Elipsit/ext-led-jewlery/.pics/FLIR0085.jpg

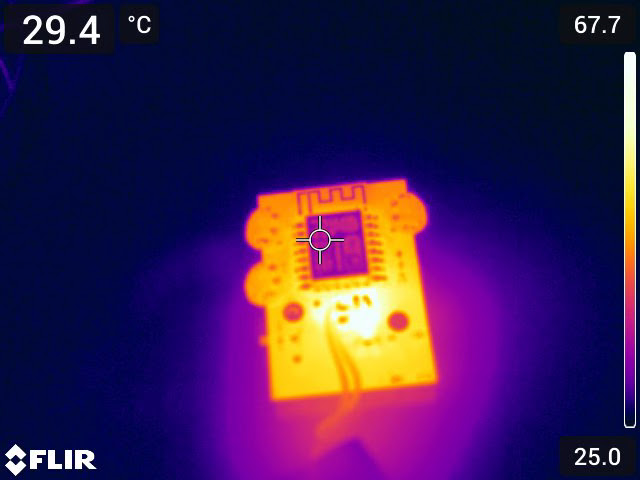
.pics/FLIR0085.jpg
