Elipsit/ext-led-jewlery/.pics/IMG_2793.PNG

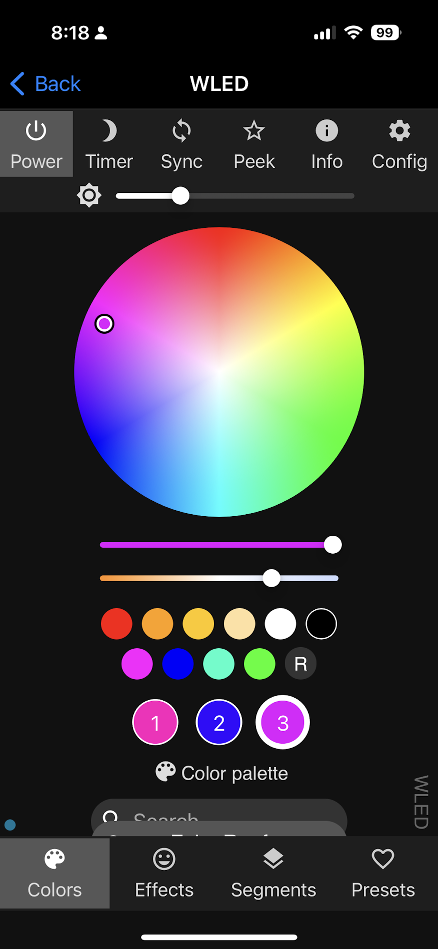
.pics/IMG_2793.PNG
