Elipsit/ext-led-jewlery/.pics/IMG_3061.jpg

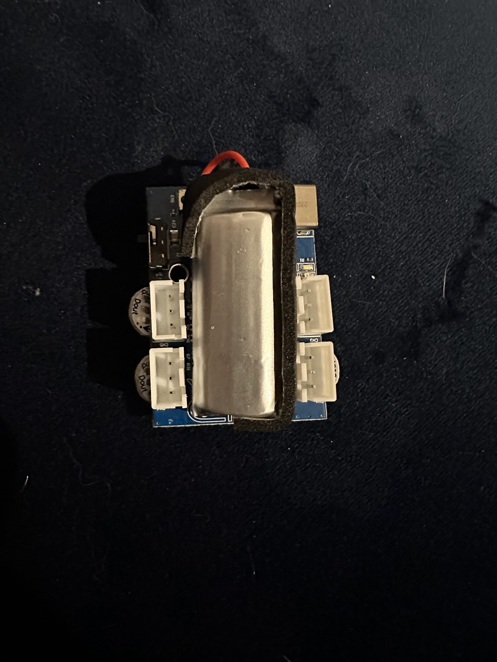
.pics/IMG_3061.jpg
