Elipsit/ext-led-jewlery/.pics/IMG_3925.jpg

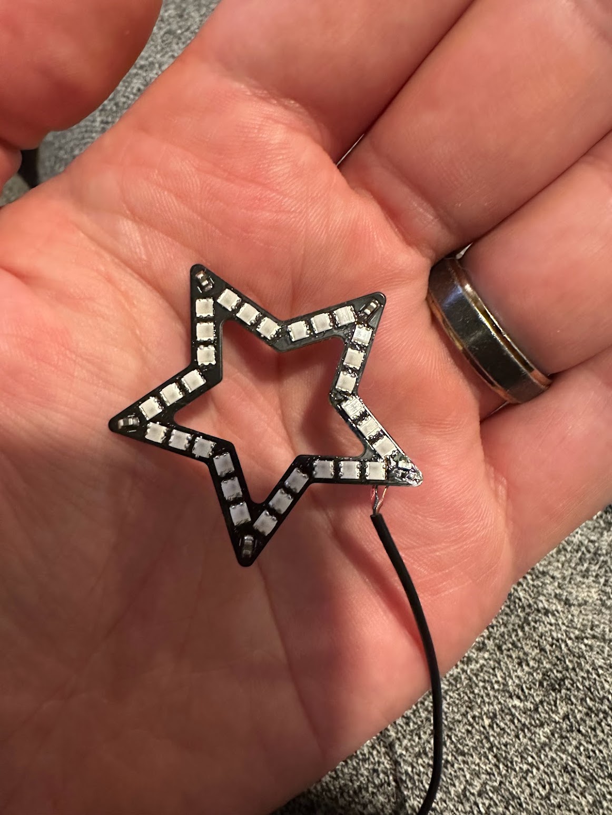
.pics/IMG_3925.jpg
