Elipsit/ext-led-jewlery/.pics/IMG_4481.jpg

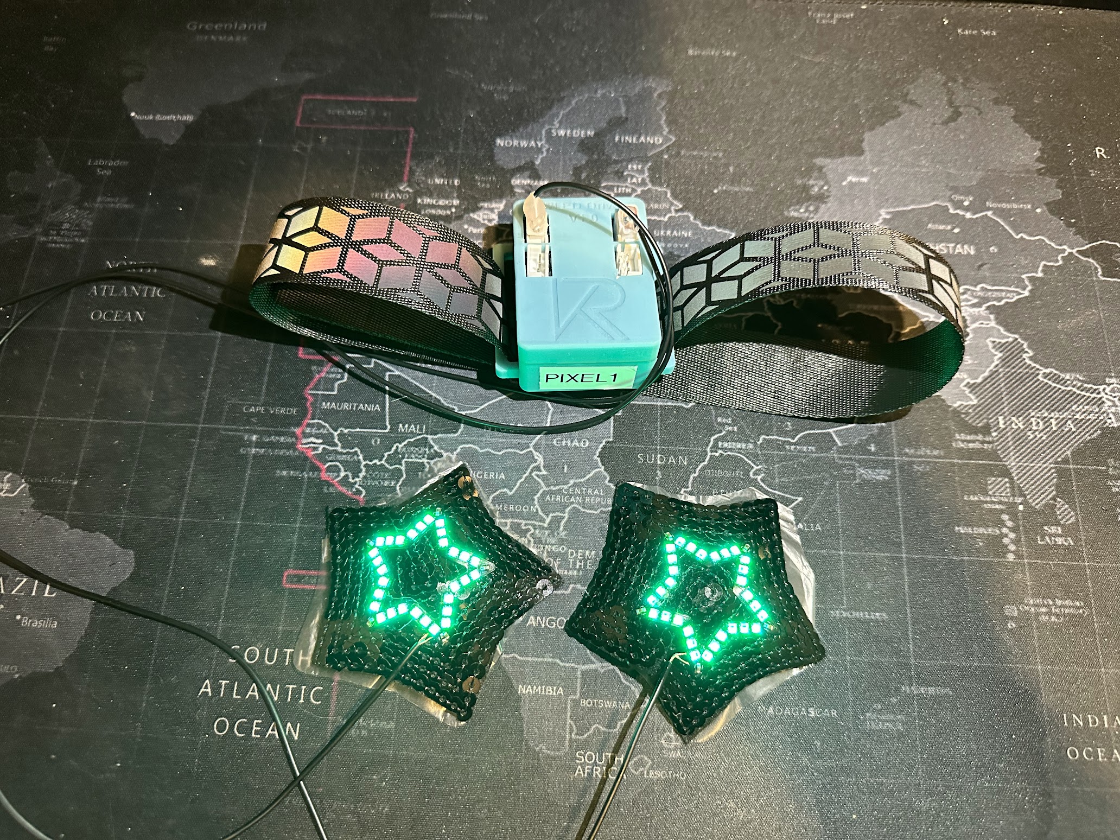
.pics/IMG_4481.jpg
