Elipsit/ext-led-jewlery/.pics/Proto.png

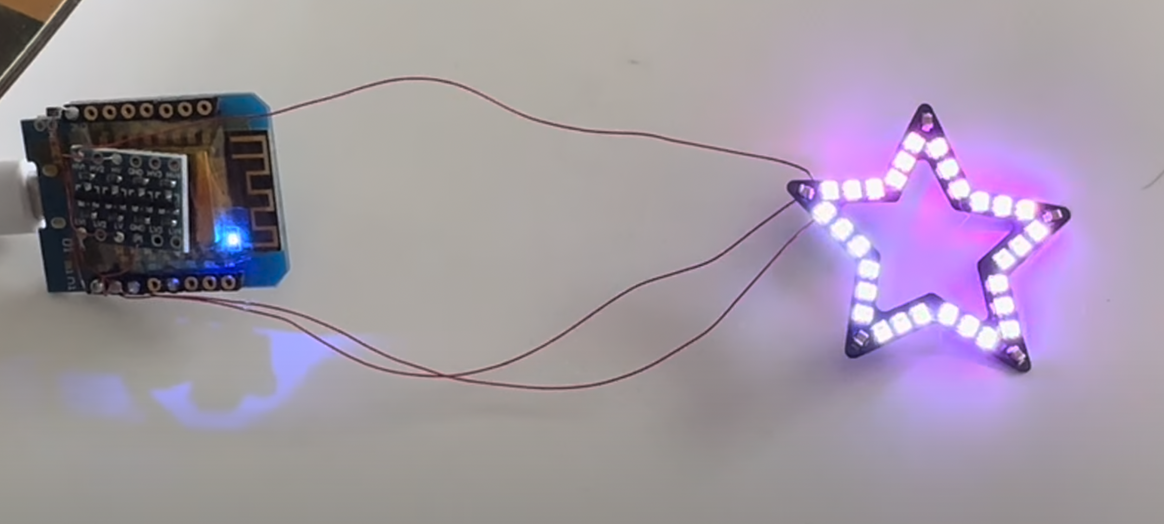
.pics/Proto.png
