Elipsit/ext-led-jewlery/EE/Project Outputs for LED_Star_RGB_Rev_A/Folder Structure/ExportSTEP/LED_Star_RGB_Rev_A.step

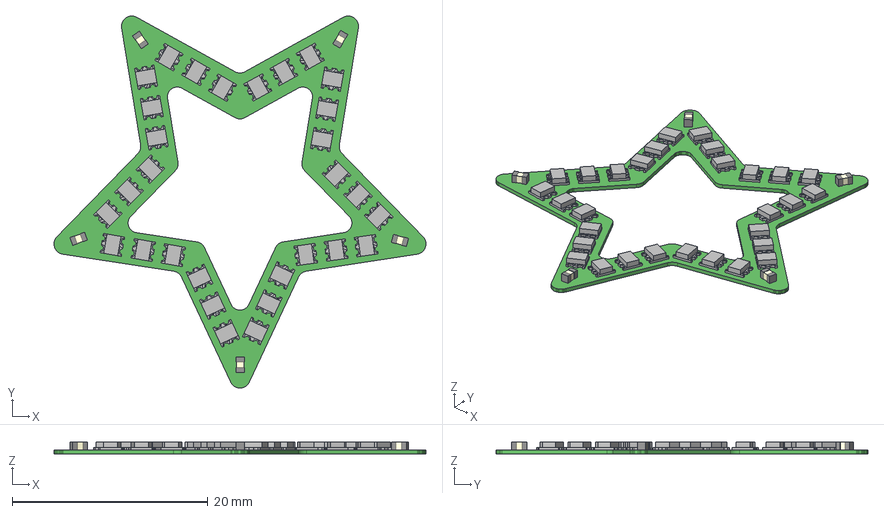
[picture p13: CAD file, 2023-07-20]
EE/Project Outputs for LED_Star_RGB_Rev_A/Folder Structure/ExportSTEP/LED_Star_RGB_Rev_A.step
38.0 x 38.0 x 1.27 mm
User Library-WS2812-2020_RGB8421504 x 30
Capacitor 0603 x 5
