Elipsit/ext-led-jewlery/ME/bot-esp-neopixel-driver-Case-tabs v42.stl

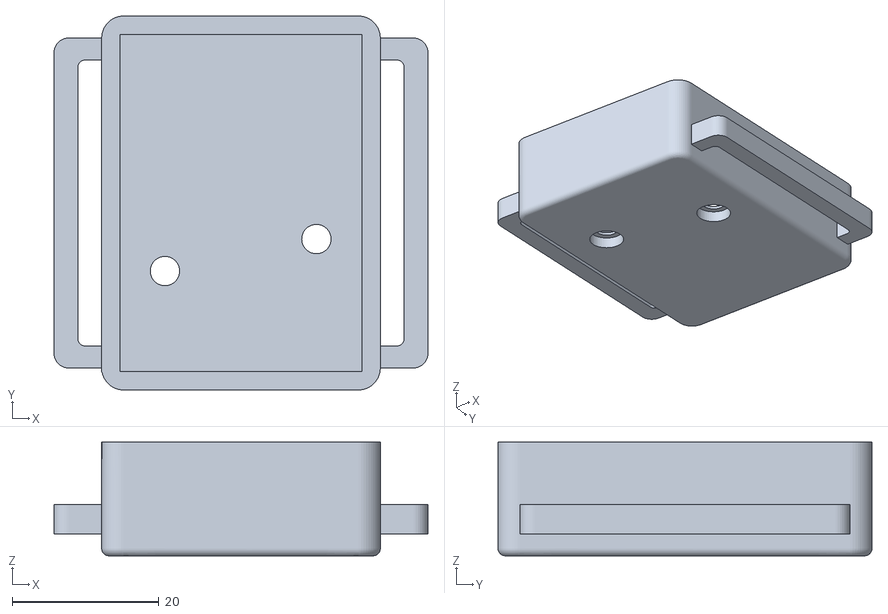
[picture p14: CAD file, 2023-07-24]
ME/bot-esp-neopixel-driver-Case-tabs v42.stl
51.0 x 51.0 x 15.5
