Elipsit/ext-led-jewlery/ME/top-esp-neopixel-driver-Case-tabs v43.stl

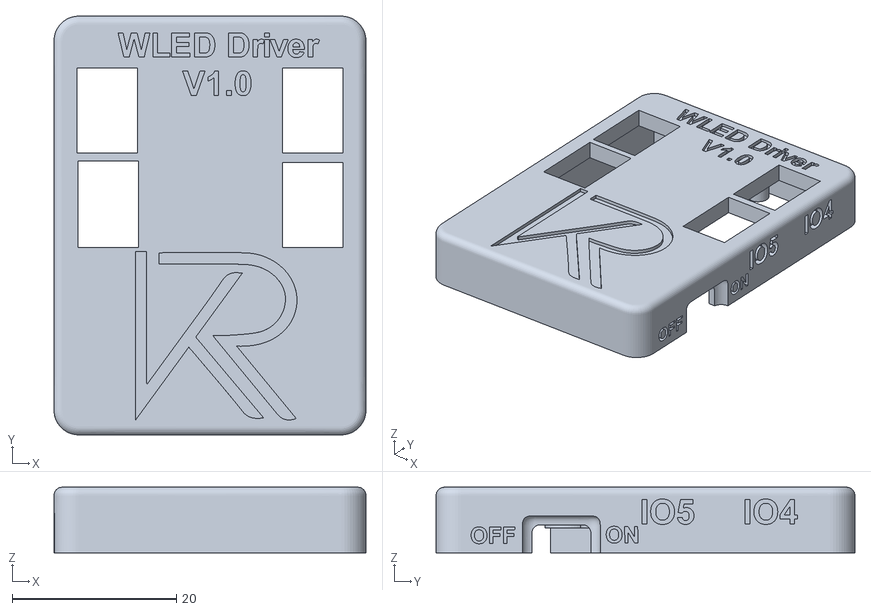
[picture p15: CAD file, 2023-07-24]
ME/top-esp-neopixel-driver-Case-tabs v43.stl
38.0 x 51.0 x 8.00
