Elipsit/ext-led-jewlery/EE/Project Outputs for esp-neopixel-driver/Schematic/esp-neopixel-driver-2023-07-03.PDF

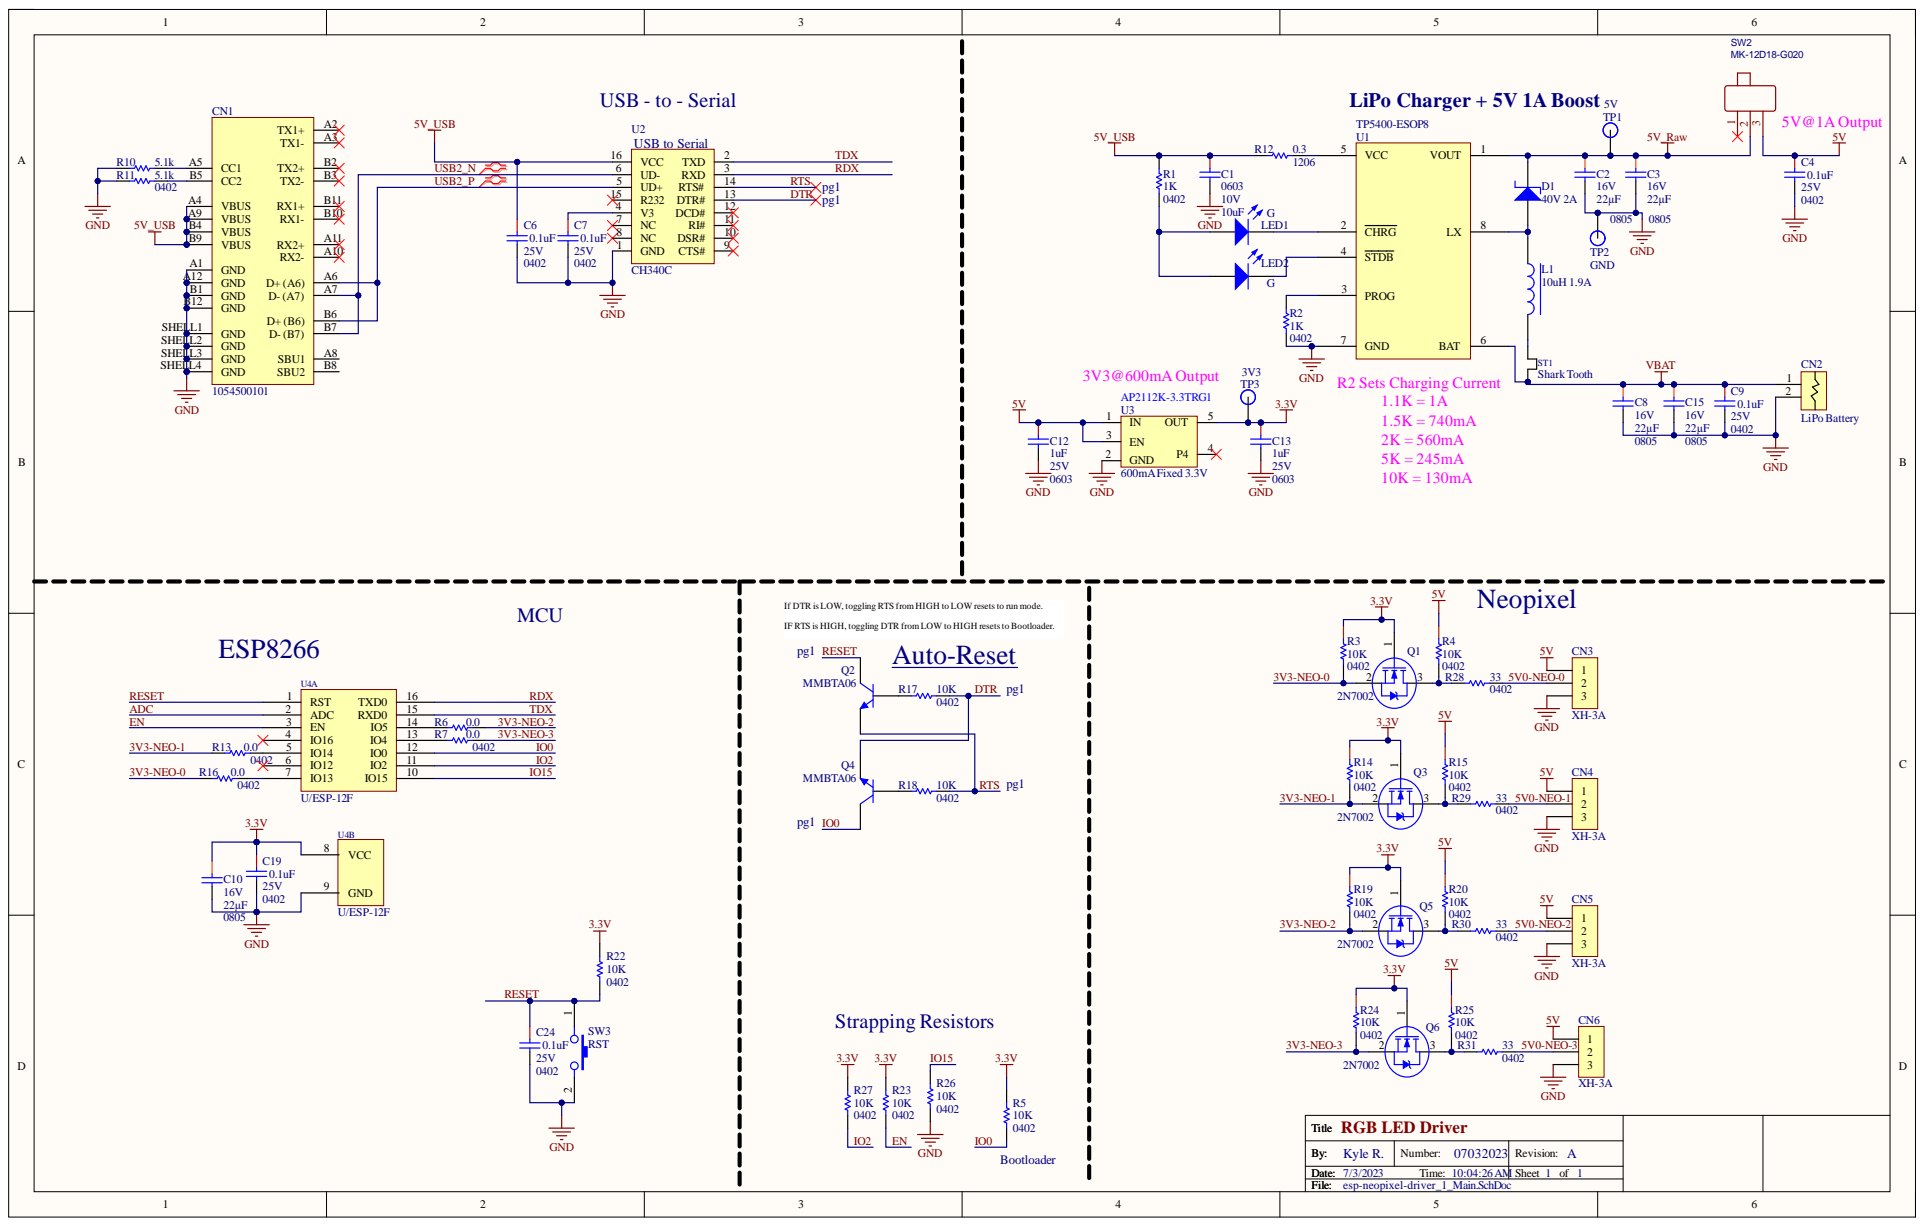
[picture p16: page 1]

If DTR is LOW, toggling RTS from HIGH to LOW resets to run mode.

IF RTS is HIGH, toggling DTR from LOW to HIGH resets to Bootloader.

RGB LED Driver Title Title

By: By: Kyle R. | Number: 07032023 | Revision: A
Date: Date: 7/3/2023 Time: 10:04:26 AM | | Sheet 1 of 1

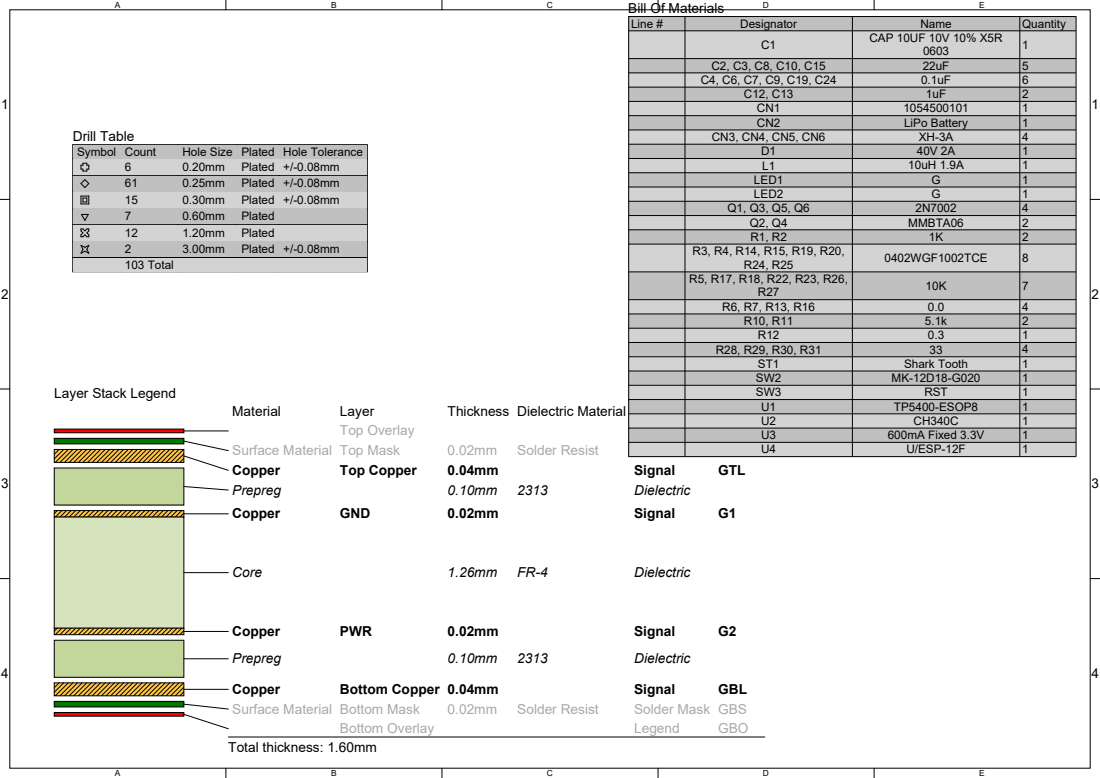
[picture p17: page 2]

Line # | Designator | Name | Quantity

C1 | CAP 10UF 10V 10% X5R 0603 | 1

C2, C3, C8, C10, C15 | 22uF | 5
C4, C6, C7, C9, C19, C24 | 0.1uF | 6

C12, C13 | 1uF | 2
CN1 | 1054500101 | 1
CN2 | LiPo Battery | 1

15 | 0.30mm | Plated | +/-0.08mm
7 | 0.60mm | Plated
12 | 1.20mm | Plated

LED2 | G | 1
Q1, Q3, Q5, Q6 | 2N7002 | 4
Q2, Q4 | MMBTA06 | 2
R1, R2 | 1K | 2

103 Total

R6, R7, R13, R16 | 0.0 | 4
R10, R11 | 5.1k | 2
R12 | 0.3 | 1

ST1 | Shark Tooth | 1
SW2 | MK-12D18-G020 | 1
SW3 | RST | 1
U1 | TP5400-ESOP8 | 1
U2 | CH340C | 1
U3 | 600mA Fixed 3.3V | 1
U4 | U/ESP-12F | 1

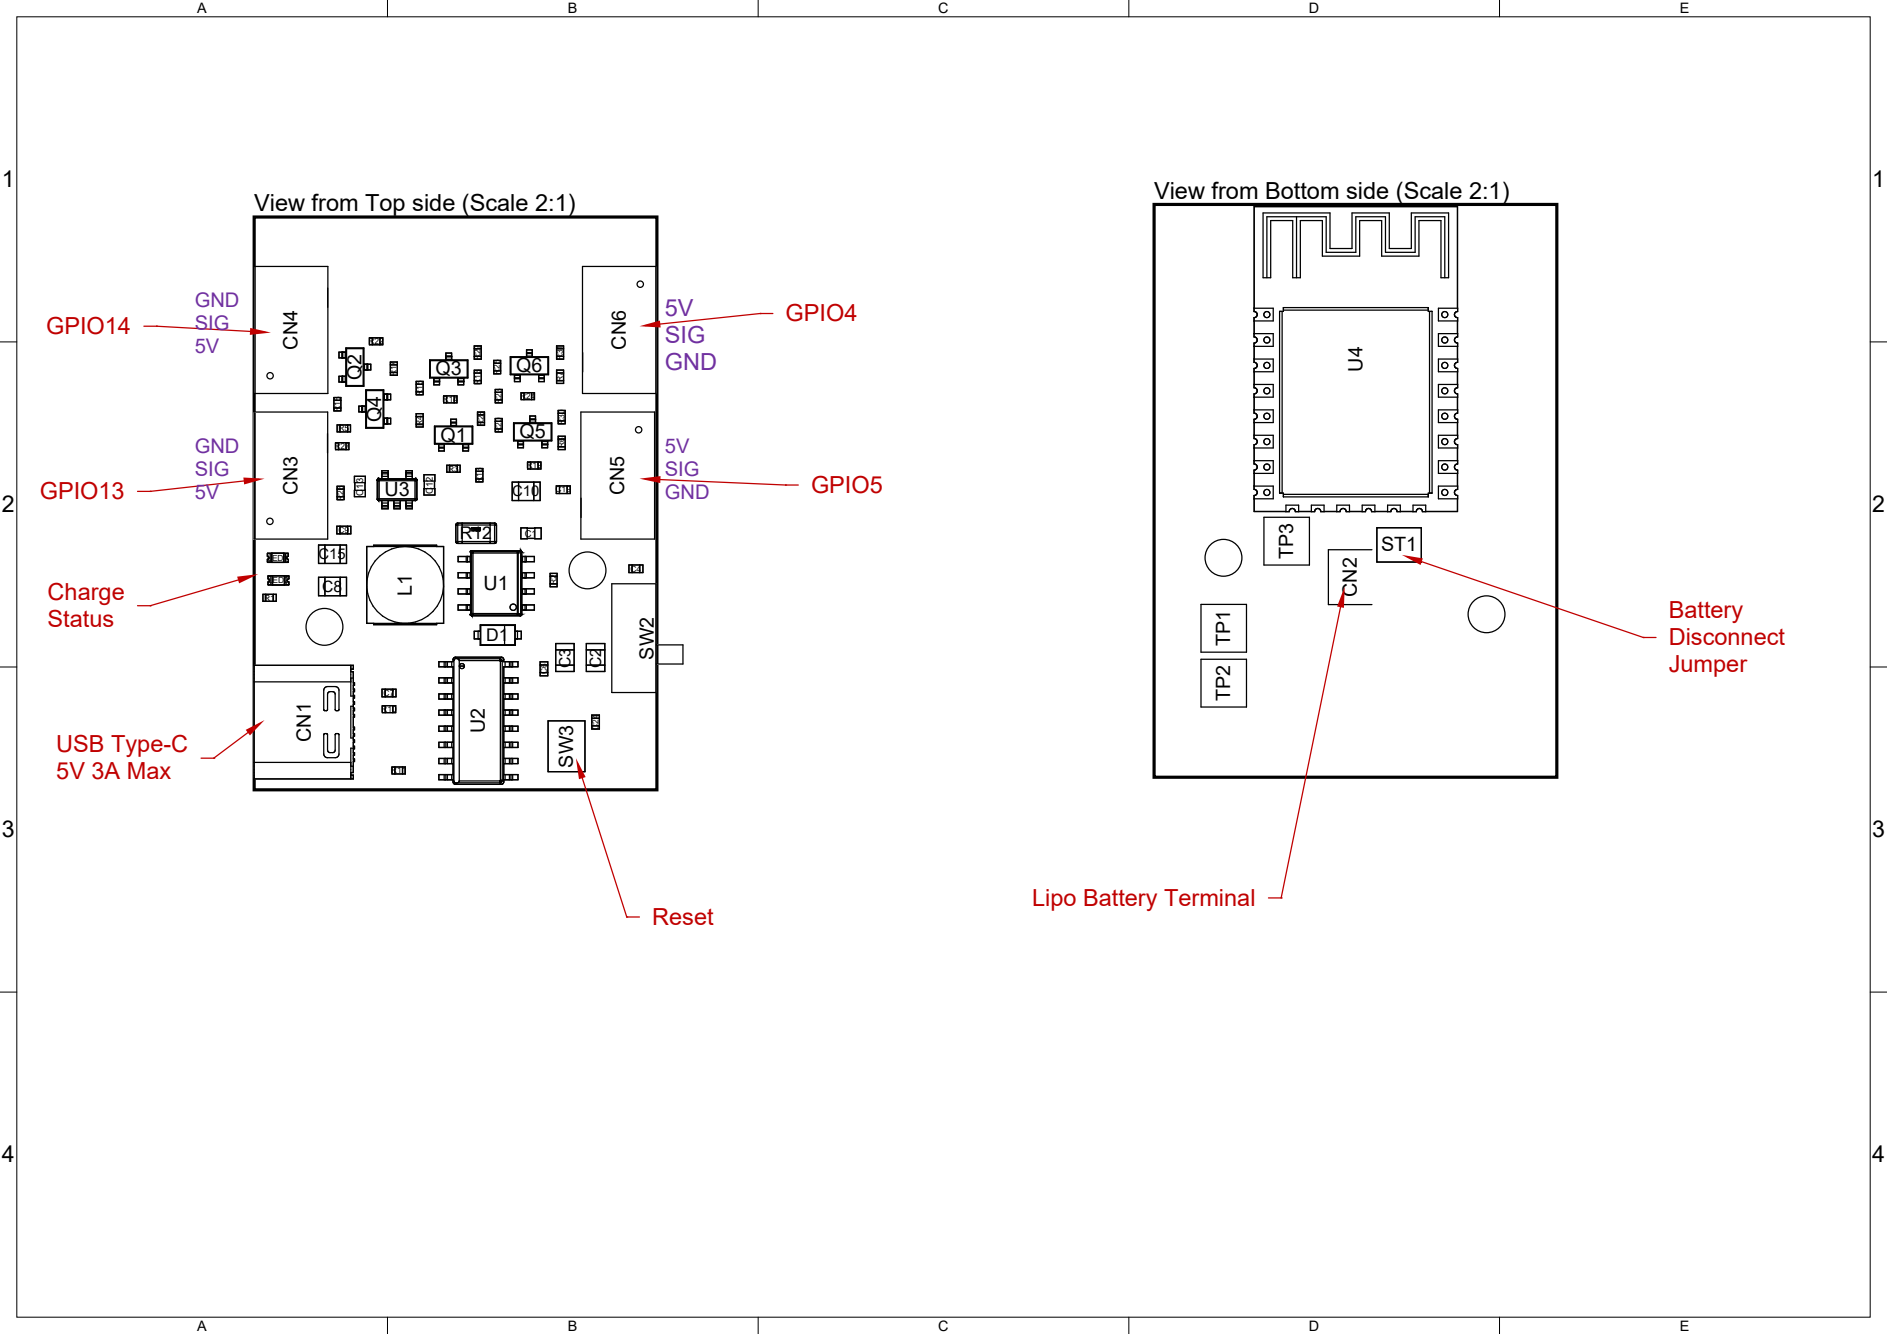
[picture p18: page 3]

View from Bottom side (Scale 2:1)

View from Top side (Scale 2:1)
