Elipsit/ext-led-jewlery/EE/Project Outputs for LED_Star_RGB_Rev_A/Schematic/LED_Star_RGB_Rev_A-2023-01-22.PDF

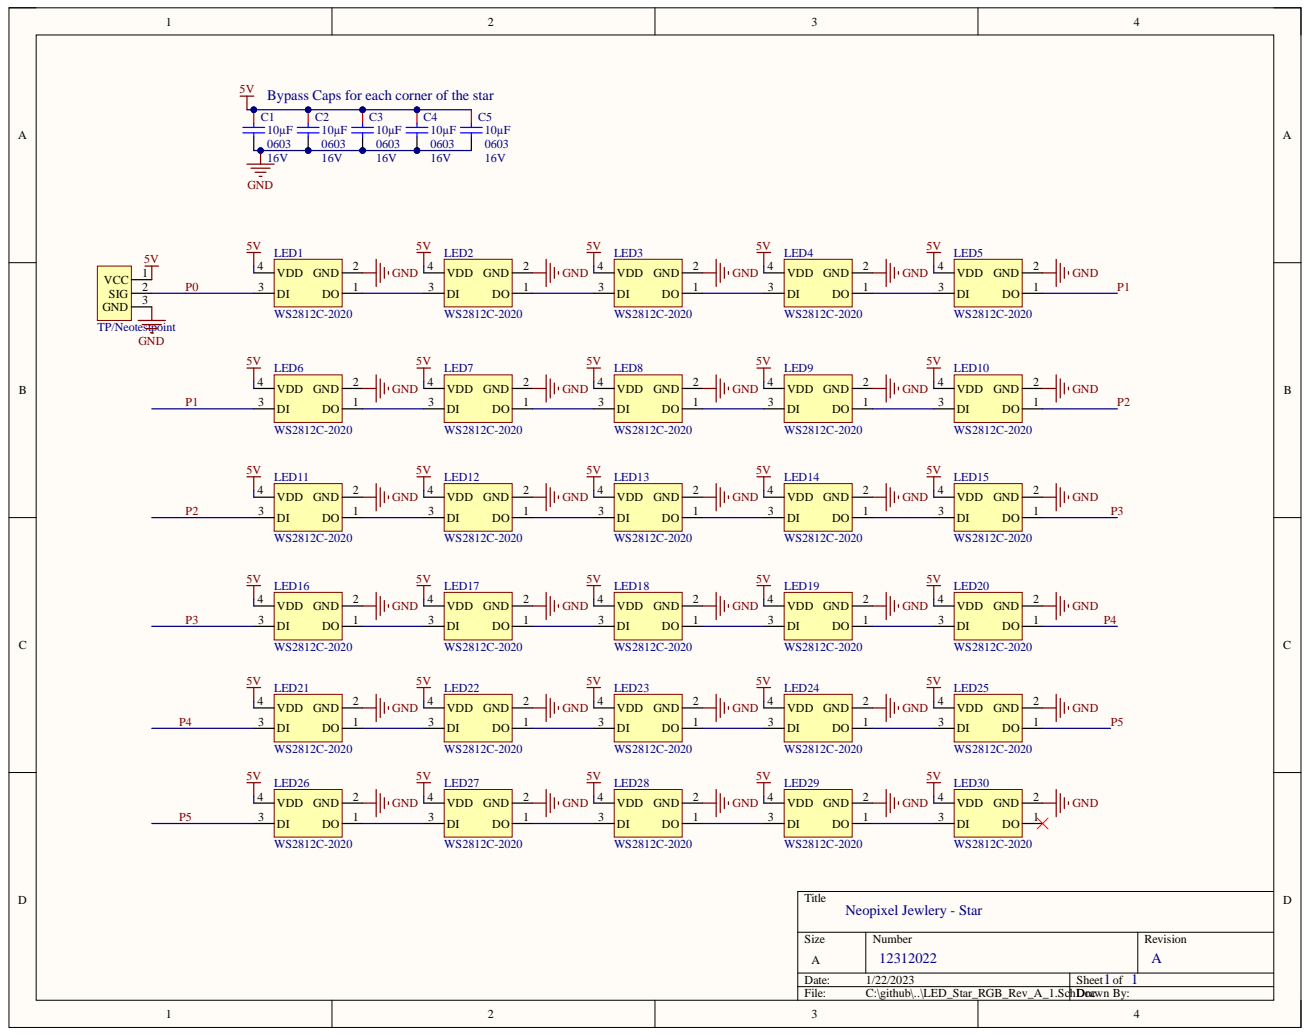
[picture p19: page 1]

Bypass Caps for each corner of the star

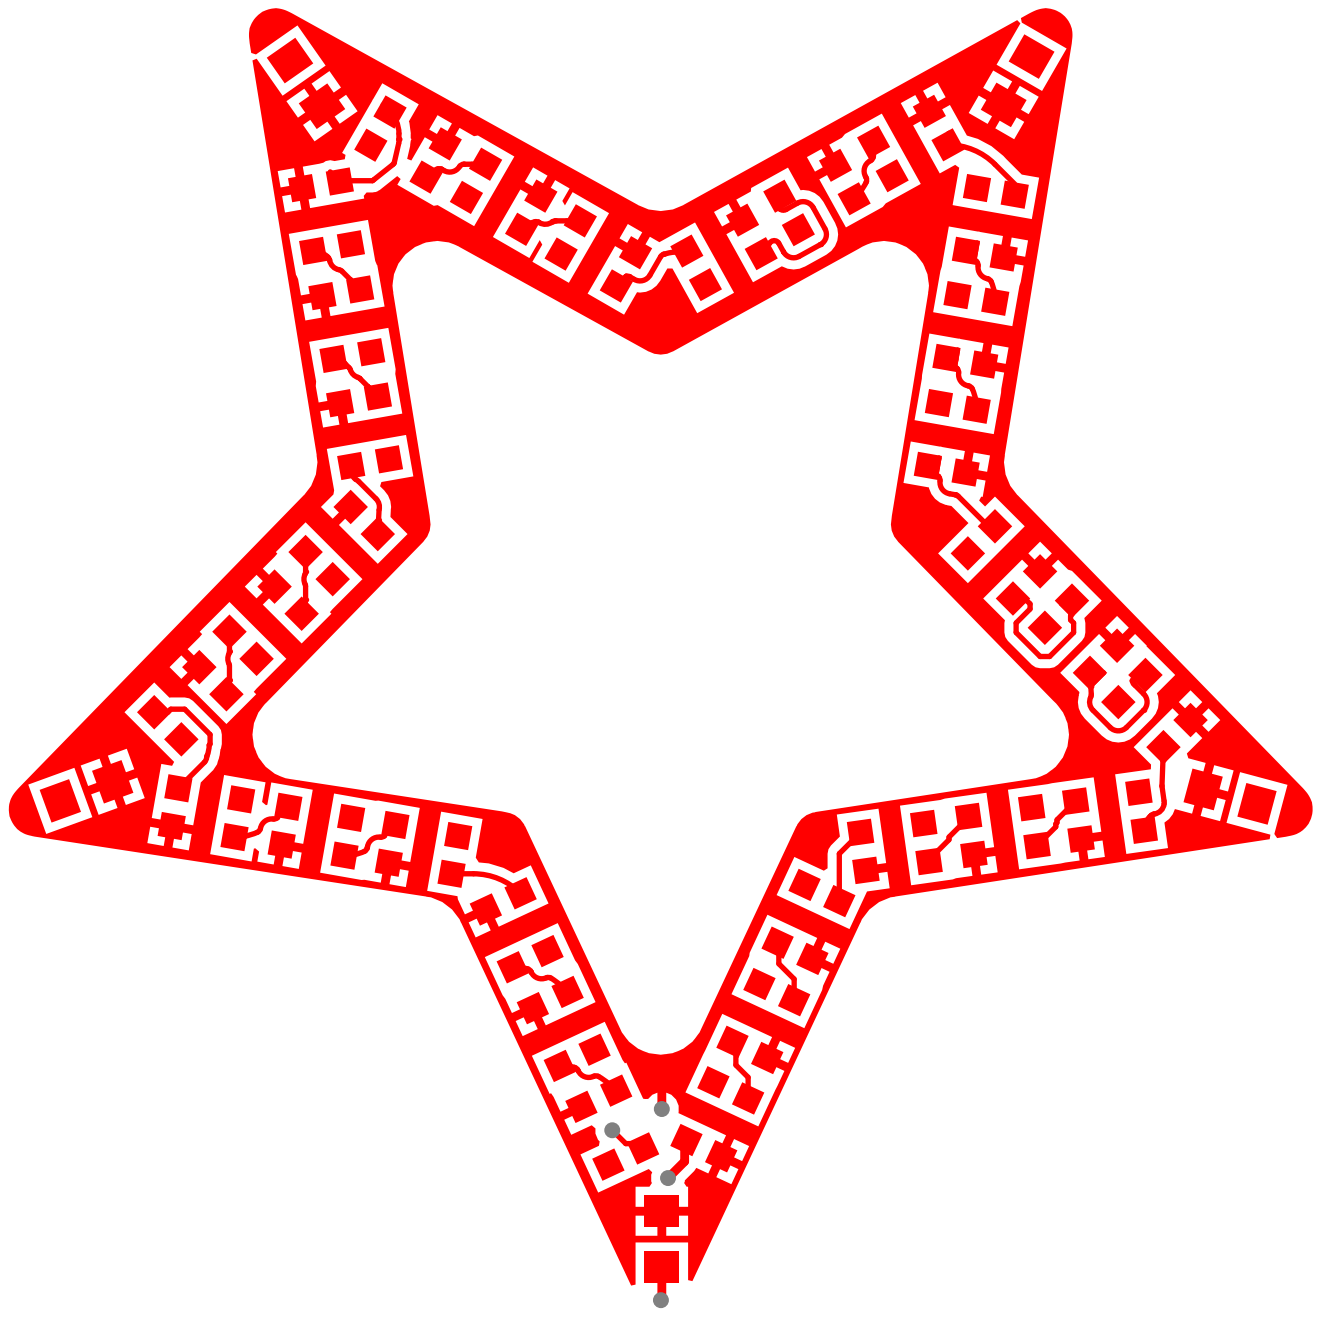
[picture p20: page 2]

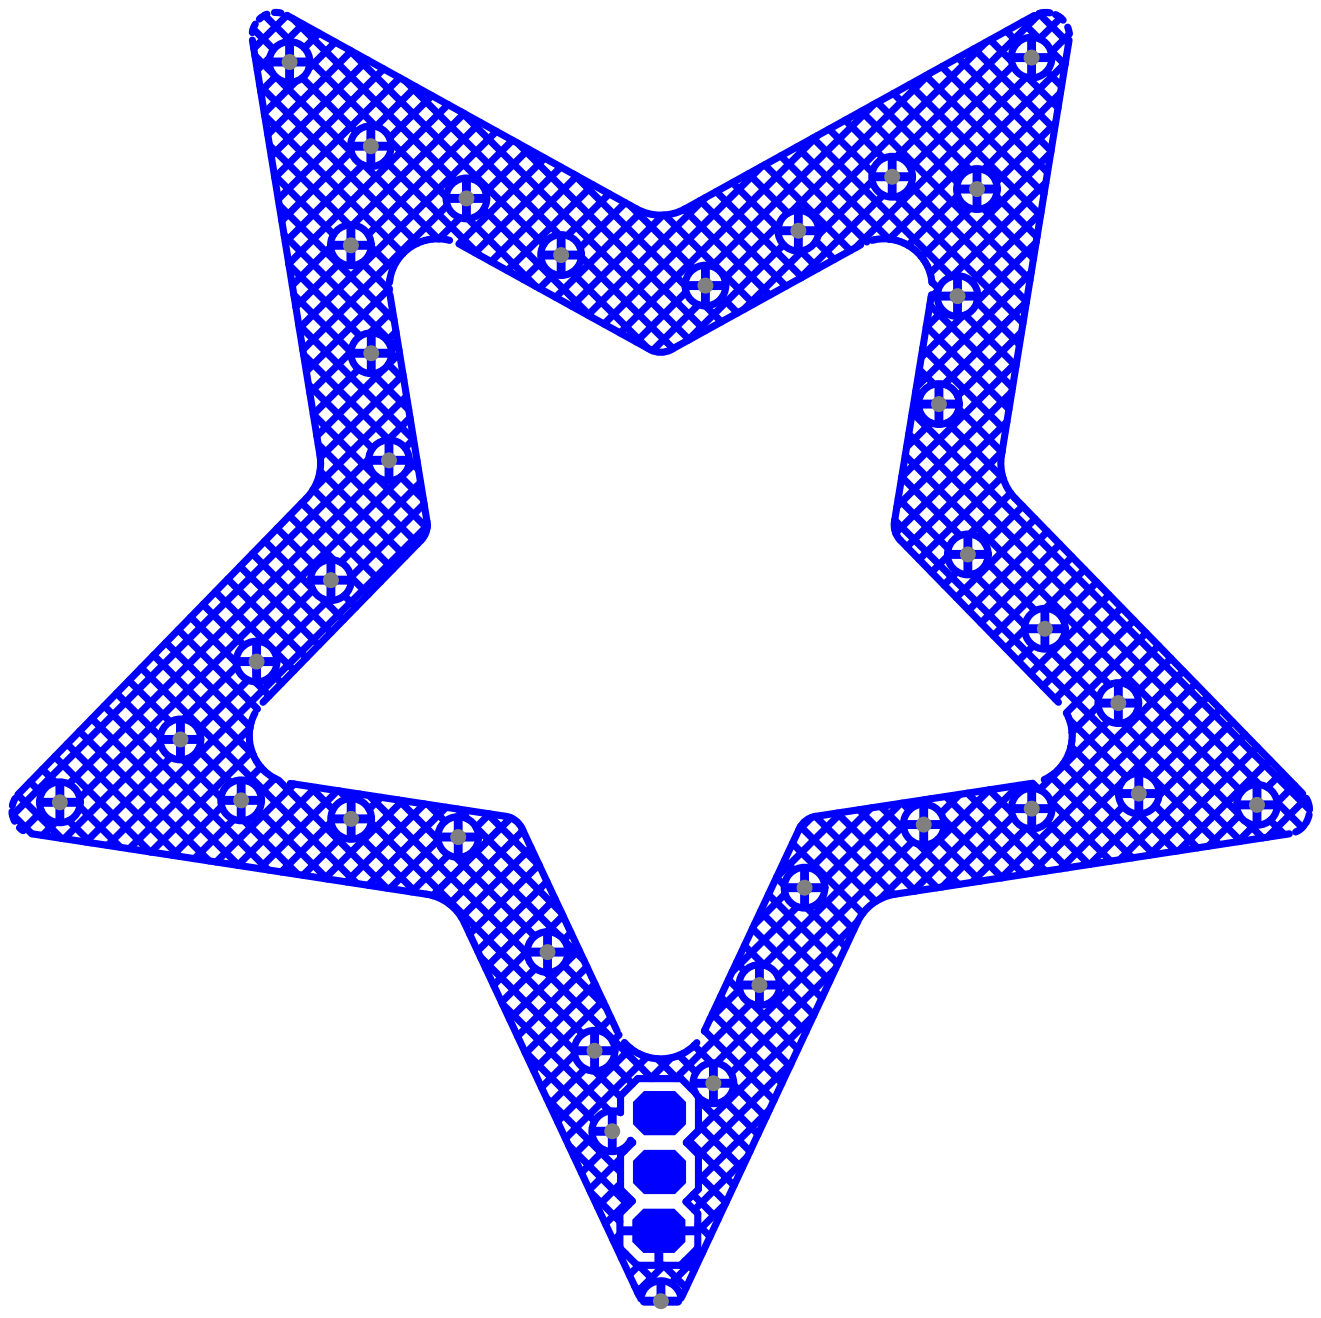
[picture p21: page 5]

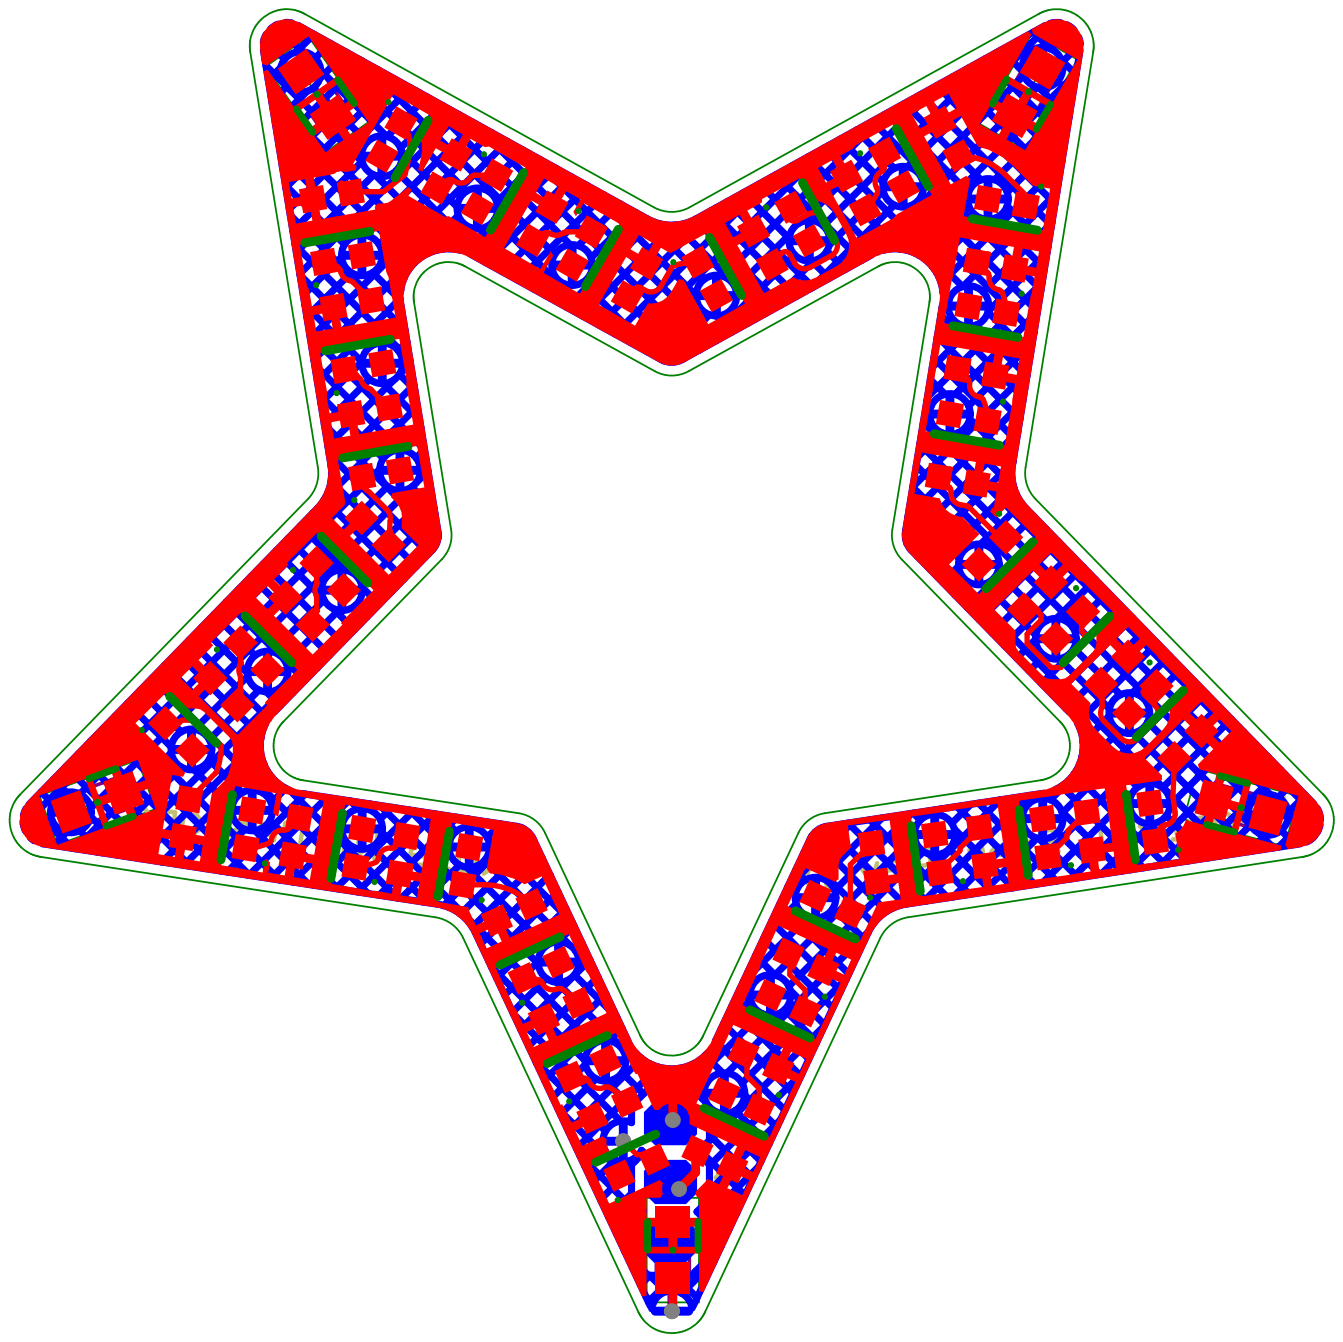
[picture p22: page 6]
