Elipsit/ext-led-jewlery/(commit log)

2023-07-20 adding export files
    [BOM_JLCSMT-esp-neopixel-driver.csv, JLCPCB-CLP1-esp-neopixel-driver.csv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]
2023-07-24 updated the working files
    [BOM_JLCSMT-esp-neopixel-driver.csv, JLCPCB-CLP1-esp-neopixel-driver.csv, Sample-BOM_JLCSMT.xlsx, bot-esp-neopixel-driver-Case-tabs v42.stl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]
